juanmcasillas/alarm/doc/relay.jpg

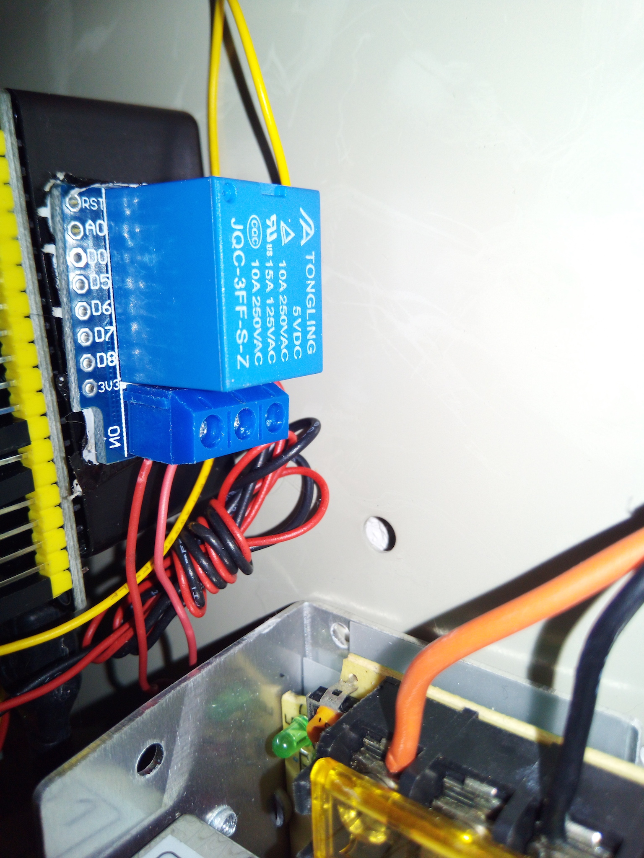
doc/relay.jpg
