juanmcasillas/alarm/doc/detector.sch

## EAGLE design doc/detector.sch (2020-01-02)

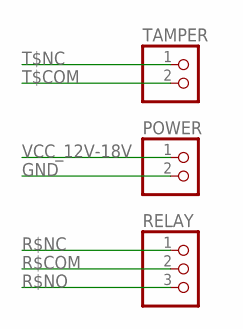
[picture p17: schematic detector.sch]

Parts:
POWER: PINHD-1X2; 1X02
RELAY: PINHD-1X3; 1X03
TAMPER: PINHD-1X2; 1X02

Connections:
GND: POWER.2
R$COM: RELAY.2
R$NC: RELAY.1
R$NO: RELAY.3
T$COM: TAMPER.2
T$NC: TAMPER.1
VCC_12V-18V: POWER.1
