juanmcasillas/alarm/doc/siren.sch

## EAGLE design doc/siren.sch (2020-01-02)

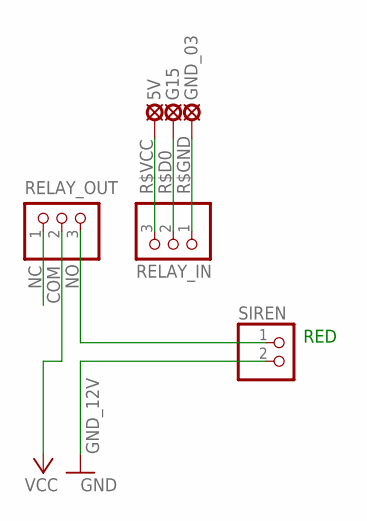
[picture p18: schematic siren.sch]

Parts:
5V: MCS08
G15: MCS08
GND_03: MCS08
RELAY_IN: PINHD-1X3; 1X03
RELAY_OUT: PINHD-1X3; 1X03
SIREN: PINHD-1X2; 1X02

Connections:
COM: RELAY_OUT.2
GND_12V: SIREN.2
NC: RELAY_OUT.1
NO: RELAY_OUT.3, SIREN.1
R$D0: G15.MP, RELAY_IN.2
R$GND: GND_03.MP, RELAY_IN.1
R$VCC: 5V.MP, RELAY_IN.3

Notes on the sheet:
RED
