juanmcasillas/alarm/doc/wiring.sch

## EAGLE design doc/wiring.sch (2020-01-02)

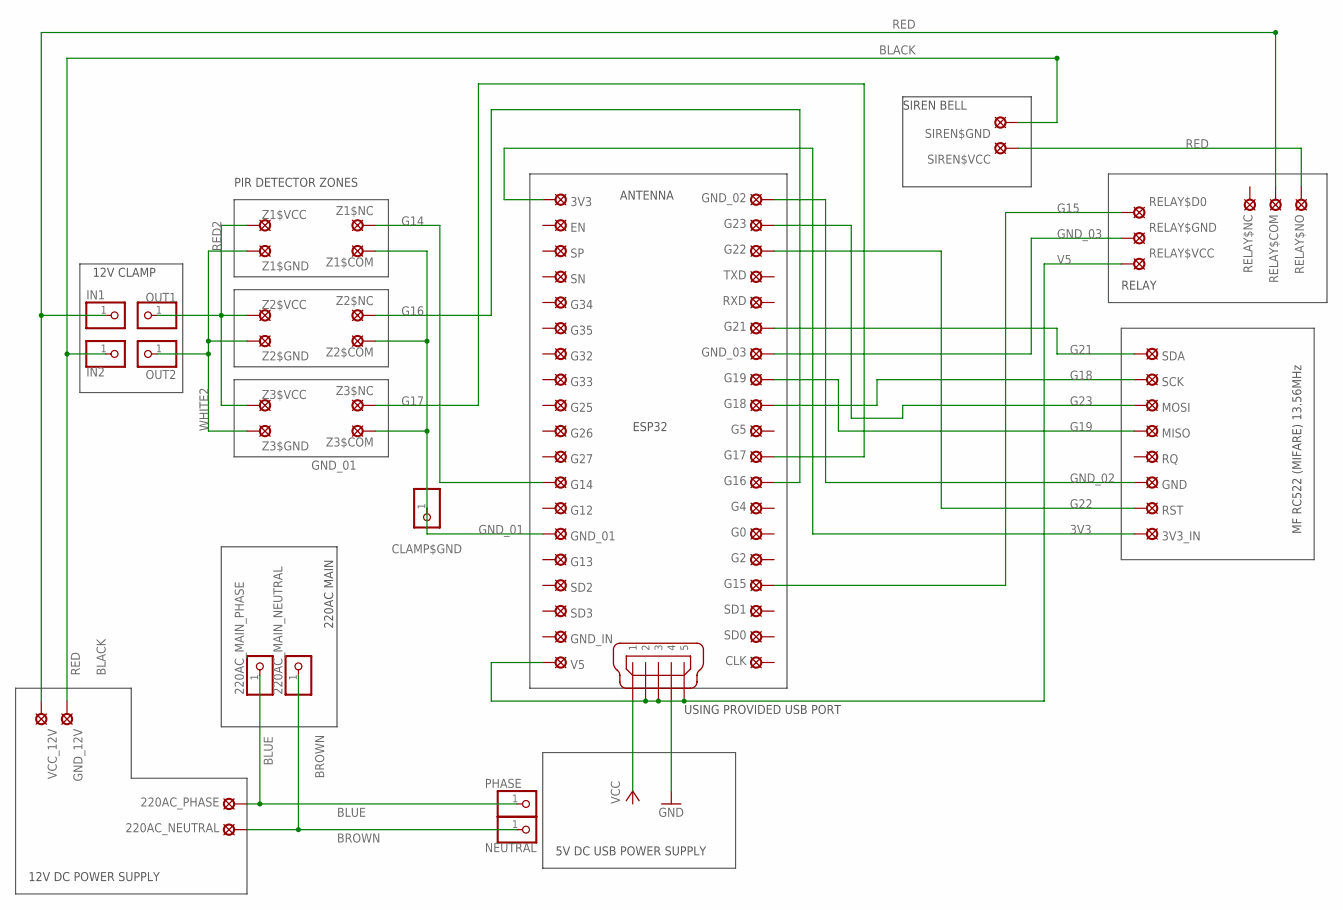
[picture p19: schematic wiring.sch]

Parts:
3V3, 3V3_IN, 220AC_NEUTRAL, 220AC_PHASE: MCS08
220AC_MAIN_NEUTRAL, 220AC_MAIN_PHASE: PINHD-1X1; 1X01
CLAMP$GND: PINHD-1X1; 1X01
CLK: MCS08
EN: MCS08
G0, G2, G4, G5, G12, G13, G14, G15, G16, G17, G18, G19, G21, G22, G23, G25, G26, G27, G32, G33, G34, G35: MCS08
GND: MCS08
GND_01, GND_02, GND_03, GND_12V: MCS08
GND_IN: MCS08
IN1, IN2: PINHD-1X1; 1X01
MISO: MCS08
MOSI: MCS08
NEUTRAL: PINHD-1X1; 1X01
OUT1, OUT2: PINHD-1X1; 1X01
PHASE: PINHD-1X1; 1X01
RELAY$COM: MCS08
RELAY$D0: MCS08
RELAY$GND: MCS08
RELAY$NC: MCS08
RELAY$NO: MCS08
RELAY$VCC: MCS08
RQ: MCS08
RST: MCS08
RXD: MCS08
SCK: MCS08
SD0, SD1, SD2, SD3: MCS08
SDA: MCS08
SIREN$GND: MCS08
SIREN$VCC: MCS08
SN: MCS08
SP: MCS08
TXD: MCS08
V5: MCS08
VCC_12V: MCS08
X1: MINI-USB_SHIELD5P2-32005-601; 32005-601
Z1$COM, Z1$GND, Z1$NC, Z1$VCC, Z2$COM, Z2$GND, Z2$NC, Z2$VCC, Z3$COM, Z3$GND, Z3$NC, Z3$VCC: MCS08

Connections:
3V3: 3V3.MP, 3V3_IN.MP
BLACK: GND_12V.MP, IN2.1, SIREN$GND.MP
BLUE: 220AC_MAIN_PHASE.1, 220AC_PHASE.MP, PHASE.1
BROWN: 220AC_MAIN_NEUTRAL.1, 220AC_NEUTRAL.MP, NEUTRAL.1
G14: G14.MP, Z1$NC.MP
G15: G15.MP, RELAY$D0.MP
G16: G16.MP, Z2$NC.MP
G17: G17.MP, Z3$NC.MP
G18: G18.MP, SCK.MP
G19: G19.MP, MISO.MP
G21: G21.MP, SDA.MP
G22: G22.MP, RST.MP
G23: G23.MP, MOSI.MP
GND: X1.4
GND_01: CLAMP$GND.1, GND_01.MP, Z1$COM.MP, Z2$COM.MP, Z3$COM.MP
GND_02: GND.MP, GND_02.MP
GND_03: GND_03.MP, RELAY$GND.MP
RED: IN1.1, RELAY$COM.MP, RELAY$NO.MP, SIREN$VCC.MP, VCC_12V.MP
RED2: OUT1.1, Z1$VCC.MP, Z2$VCC.MP, Z3$VCC.MP
V5: RELAY$VCC.MP, V5.MP, X1.2, X1.3, X1.5
WHITE2: OUT2.1, Z1$GND.MP, Z2$GND.MP, Z3$GND.MP

Notes on the sheet:
5V DC USB POWER SUPPLY
USING PROVIDED USB PORT
220AC MAIN
12V DC POWER SUPPLY
12V CLAMP
SIREN BELL
RELAY
MF RC522 (MIFARE) 13.56MHz
ANTENNA
ESP32
PIR DETECTOR ZONES
