juanmcasillas/alarm/Software/dev/webserver/webserver.ino

#include <ArduinoOTA.h>
#ifdef ESP32
#include <FS.h>
#include <SPIFFS.h>
#include <ESPmDNS.h>
#include <WiFi.h>
#include <AsyncTCP.h>
#include <esp_system.h>
#elif defined(ESP8266)
#include <ESP8266WiFi.h>
#include <ESPAsyncTCP.h>
#include <ESP8266mDNS.h>
#endif
#include <ESPAsyncWebServer.h>
#include <SPIFFSEditor.h>
#include <WiFiUdp.h>
#include <ArduinoOTA.h>


// SKETCH BEGIN
AsyncWebServer server(80);

// {"ssid":"XXXXXXX","pass":"YYYYYY","ip":[192,168,1,252],"netmask":[255,255,255,0],"gateway":[192,168,1,1],"dns":[8,8,8,8],"dhcp":false,"ntp":"es.pool.ntp.org","NTPperiod":15,"timeZone":10,"daylight":true,"deviceName":"Alarm"}
const char* ssid = "XXXXXXX";
const char* password = "YYYYYY";
const char * hostName = "esp-async";
const char* http_username = "admin";
const char* http_password = "admin";




String getMacAddress() {
	uint8_t baseMac[6];
	// Get MAC address for WiFi station
	esp_read_mac(baseMac, ESP_MAC_WIFI_STA);
	char baseMacChr[18] = {0};
	sprintf(baseMacChr, "%02X:%02X:%02X:%02X:%02X:%02X", baseMac[0], baseMac[1], baseMac[2], baseMac[3], baseMac[4], baseMac[5]);
	return String(baseMacChr);
}
void setup_IP() {

    IPAddress local_IP(192, 168, 1, 253);
    IPAddress gateway(192, 168, 1, 1);
    IPAddress subnet(255, 255, 255, 0);
    IPAddress primaryDNS(8, 8, 8, 8);   //optional
  

    if (!WiFi.config(local_IP, gateway, subnet, primaryDNS)) {
        Serial.println("STA Failed to configure");
    }

}

void setup_AP() {
     Serial.printf("setup_AP()\n");
     WiFi.softAP(ssid, password);
}

int setup_STA(int times) {
     WiFi.mode(WIFI_AP_STA);
     WiFi.softAP(hostName);
     WiFi.begin(ssid, password);
    
    int counter =0;
    while (WiFi.waitForConnectResult() != WL_CONNECTED) {
        Serial.printf("STA: Failed!\n");
        WiFi.disconnect(false);
        delay(1000);
        WiFi.begin(ssid, password);
        counter++;
        if (counter == times) {
            Serial.printf("Max Retires happen (%d). Exiting\n", times);
            return(0);
        }
    }
    return(1);

}

void setup_OTA() {

  // Port defaults to 8266
  // ArduinoOTA.setPort(8266);
  // Hostname defaults to esp8266-[ChipID]
  // ArduinoOTA.setHostname("myesp8266");
  // No authentication by default
  // ArduinoOTA.setPassword("admin");
  // Password can be set with it's md5 value as well
  // MD5(admin) = 21232f297a57a5a743894a0e4a801fc3
  // ArduinoOTA.setPasswordHash("21232f297a57a5a743894a0e4a801fc3");

    ArduinoOTA.onStart([]() {
    String type;
    if (ArduinoOTA.getCommand() == U_FLASH) {
      type = "sketch";
    } else { // U_SPIFFS
      type = "filesystem";
    }

    // NOTE: if updating SPIFFS this would be the place to unmount SPIFFS using SPIFFS.end()
    Serial.println("Start updating " + type);
  });
  ArduinoOTA.onEnd([]() {
    Serial.println("\nEnd");
  });
  ArduinoOTA.onProgress([](unsigned int progress, unsigned int total) {
    Serial.printf("Progress: %u%%\r", (progress / (total / 100)));
  });
  ArduinoOTA.onError([](ota_error_t error) {
    Serial.printf("Error[%u]: ", error);
    if (error == OTA_AUTH_ERROR) {
      Serial.println("Auth Failed");
    } else if (error == OTA_BEGIN_ERROR) {
      Serial.println("Begin Failed");
    } else if (error == OTA_CONNECT_ERROR) {
      Serial.println("Connect Failed");
    } else if (error == OTA_RECEIVE_ERROR) {
      Serial.println("Receive Failed");
    } else if (error == OTA_END_ERROR) {
      Serial.println("End Failed");
    }
  });
  ArduinoOTA.begin();
  Serial.println("Ready");
  Serial.print("IP address: ");
  Serial.println(WiFi.localIP());
}

void setup(){
  Serial.begin(115200);
  Serial.setDebugOutput(true);
  Serial.println("Serial Init OK"); 
  Serial.printf("MAC Address: %s\n",getMacAddress().c_str());
  
  setup_IP();
  setup_STA(5);
  setup_OTA();
 
  MDNS.addService("http","tcp",80);
  SPIFFS.begin();


  
#ifdef ESP32
  server.addHandler(new SPIFFSEditor(SPIFFS, http_username,http_password));
#elif defined(ESP8266)
  server.addHandler(new SPIFFSEditor(http_username,http_password));
#endif
  
  server.on("/heap", HTTP_GET, [](AsyncWebServerRequest *request){
    request->send(200, "text/plain", String(ESP.getFreeHeap()));
  });

  server.serveStatic("/", SPIFFS, "/").setDefaultFile("index.html");

  server.onNotFound([](AsyncWebServerRequest *request){
    Serial.printf("NOT_FOUND: ");
    if(request->method() == HTTP_GET)
      Serial.printf("GET");
    else if(request->method() == HTTP_POST)
      Serial.printf("POST");
    else if(request->method() == HTTP_DELETE)
      Serial.printf("DELETE");
    else if(request->method() == HTTP_PUT)
      Serial.printf("PUT");
    else if(request->method() == HTTP_PATCH)
      Serial.printf("PATCH");
    else if(request->method() == HTTP_HEAD)
      Serial.printf("HEAD");
    else if(request->method() == HTTP_OPTIONS)
      Serial.printf("OPTIONS");
    else
      Serial.printf("UNKNOWN");
    Serial.printf(" http://%s%s\n", request->host().c_str(), request->url().c_str());

    if(request->contentLength()){
      Serial.printf("_CONTENT_TYPE: %s\n", request->contentType().c_str());
      Serial.printf("_CONTENT_LENGTH: %u\n", request->contentLength());
    }

    int headers = request->headers();
    int i;
    for(i=0;i<headers;i++){
      AsyncWebHeader* h = request->getHeader(i);
      Serial.printf("_HEADER[%s]: %s\n", h->name().c_str(), h->value().c_str());
    }

    int params = request->params();
    for(i=0;i<params;i++){
      AsyncWebParameter* p = request->getParam(i);
      if(p->isFile()){
        Serial.printf("_FILE[%s]: %s, size: %u\n", p->name().c_str(), p->value().c_str(), p->size());
      } else if(p->isPost()){
        Serial.printf("_POST[%s]: %s\n", p->name().c_str(), p->value().c_str());
      } else {
        Serial.printf("_GET[%s]: %s\n", p->name().c_str(), p->value().c_str());
      }
    }

    request->send(404);
  });
  server.onFileUpload([](AsyncWebServerRequest *request, const String& filename, size_t index, uint8_t *data, size_t len, bool final){
    if(!index)
      Serial.printf("UploadStart: %s\n", filename.c_str());
    Serial.printf("%s", (const char*)data);
    if(final)
      Serial.printf("UploadEnd: %s (%u)\n", filename.c_str(), index+len);
  });
  server.onRequestBody([](AsyncWebServerRequest *request, uint8_t *data, size_t len, size_t index, size_t total){
    if(!index)
      Serial.printf("BodyStart: %u\n", total);
    Serial.printf("%s", (const char*)data);
    if(index + len == total)
      Serial.printf("BodyEnd: %u\n", total);
  });
  server.begin();
}

void loop(){
      ArduinoOTA.handle();
}
