juanmcasillas/alarm/Software/dev/alarm_orig/alarm.ino

#include <Arduino.h>
#include <FS.h>
#include <SPIFFS.h>


#include "config.h"
#include "logger.h"
#include "webserver.h"
#include "alarm.h"

// Implementation variable ////////////////////////////////////////////////////

AlarmClass ALARM;

#include "callback.h"

/// ARDUINO BLOCK /////////////////////////////////////////////////////////////

#define SERIAL_BAUD_RATE 115200
#define CONFIG_FILE "/config.json"
#define CALLBACK_PREFIX "/alarm"
#define LED_PIN 2
#define TEST_PIN 18 // GPIO18
void setup() {
    // ESP32 pullup pins:
    // 14, 16, 17, 18, 19, 21, 22, 23 

    pinMode(LED_PIN,OUTPUT);
    pinMode(TEST_PIN,INPUT_PULLUP);
    randomSeed(analogRead(0));

    // Serial monitor output 
    LOGGER.EnableSerialDebug(SERIAL_BAUD_RATE);

    // configure CatFeeder Objects
    SPIFFS.begin();
    CONFIG.begin(&SPIFFS,CONFIG_FILE);
    LOGGER.begin(&SPIFFS,CONFIG.log_file); 
    ALARM.begin(&SPIFFS, CONFIG.scheduled_interval);

    HELPER.Configure_NetWork();

    // configure the WebServer
    WebServer.set_usercallbackfilter(CALLBACK_PREFIX);
    WebServer.setUSERCallback(callbackHandler);
    WebServer.begin(CONFIG.http_port);
   
    // configure the logger to be served statically
    // maybe all the static elements in the directory
    // should be handled in this way.
    // ESPHTTPServer.serveStatic("/catfeeder.log", SPIFFS, "/catfeeder.log");

    ALARM.IsRunning();
    /* add setup code here */
}

/// MAIN LOOP /////////////////////////////////////////////////////////////////



void loop() {

    //led test
    //delay(500);
    //digitalWrite(LED_PIN,HIGH); //off
    //delay(500);
    //digitalWrite(LED_PIN,LOW); // on
    
    //read test
    //int val = digitalRead(TEST_PIN);
    //DEBUGLOG("Val: %d\n",val);
    //delay(500);


    /* add main program code here */
    // DO NOT REMOVE. Attend OTA update from Arduino IDE
    WebServer.handle();	
}
