juanmcasillas/alarm/(commit log)

2019-12-26 Initial GIT Commit.
    This version supports:
    * WiFi AP/STA mode
    * WiFi switchback from STA to AP
    * JSON config file
    * Log facility file
    * Async Webserver
    * Callback handlers
2019-12-26 Added a simple PULLUP example PIR circuits (in my case) are wired NC (Normally Closed) so we need a PULLUP configuration to read the values.
2019-12-27 Test client working with ESP32 and ARDUINO in all the pins
2019-12-28 Added RFID support for ESP32 Added a reading example for ESP32
2019-12-28 Added a full test integration with RFID, DigitalInputs and Relay
2019-12-29 First working release with the alarm
    the system works with RFID enabled card (arm, disarm) and alarm relay work. please use this sketch as reference for pinout.
2019-12-30 Added support for JS and HTML code to see and change some configuration files for the application (mainly enable/disable zones, mute alarm, and check the current status of the alarm)
2019-12-31 Fixed the HTML - JSON interface with Arduino Set the time from client (UTC) if started as AP Save the configuration Parse the args as JSON string
    [alarm.cpp, alarm.h, callback.h, config.h, helper.cpp, webserver.cpp, webserver.h]
2019-12-31 Added support for ARMING/DISARMING with valid keys Fixing some problems with the RINGING interface Added mute & time millis() to support SIREN ring
2019-12-31 Fixed the out of sync code
    [alarm.cpp, alarm.h, alarm.ino, callback.h, config.h, logger.cpp, webserver.cpp, webserver.h]
2019-12-31 Added digitalWrite to stop the alarm TODO: add a wait time before armor the alarm Integration test with the wires works.
2020-01-01 Created a State Machine to support DISARMED, ARMED_DELAY, ARMED Fixed the WWW interface - RFID interface for command input Added a beeper confirmation for ARMED_DELAY Added required configuration for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
    [alarm.cpp, alarm.h, alarm.ino, config.cpp, config.h, logger.cpp]
2020-01-02 Added the wiring diagram and improve some documentation
    [wiring.sch]
2020-01-02 Improved the documentation
    [detector.sch, siren.sch]
2020-01-04 Added improved documentation Added more images Fixed config.html and index.html viewports
    [alarm.ino, config.h, rfid.ino]
